H4riiii/MC/(commit log)

2026-10-12 added button and oled functioning. LED and Buzzer left.
2026-11-02 Add STM32 Smart Pill Box firmware, DS1307 RTC, SD card logging, and docs
2026-11-02 Update evaluation docs: SD Card SPI1 subsystem, I2C scanner, voltage constraints, and viva QA
2026-11-02 Clean up old ghost Arduino/Wokwi files and consolidate on official STM32 firmware in Core/
2026-11-02 Add on-OLED 3-day dosage log viewer, fix RTC persistence, implement SPI SD card logging and config storage, and update technical documentation and PDFs
2026-11-02 Apply Page Addressing Mode 0x02, DC-DC charge pump stabilization delay, and pre-init I2C bus recovery
2026-11-02 Add startup I2C ACK diagnostic: LED1 blinks fast for 5s if NO ACK, do nothing if ACK received
2026-11-02 Fix OLED not lighting up: restore 0x00 horizontal addressing mode, remove bus recovery pin remapping, and flush blank buffer before display ON
2026-11-02 Temporary hardware diagnostic: LED1 ON if OLED detected (0x3C), LED2 ON if RTC detected (0x68), both ON if both OK
2026-11-02 OLED: remove frame buffer (per-page rendering), restore a335f8b init
2026-11-02 OLED self-test and present check, SD init diagnostics and SPI timeouts, add full hardware test
